Hoog-V/APPS_PCB/Smaller_prototype.step

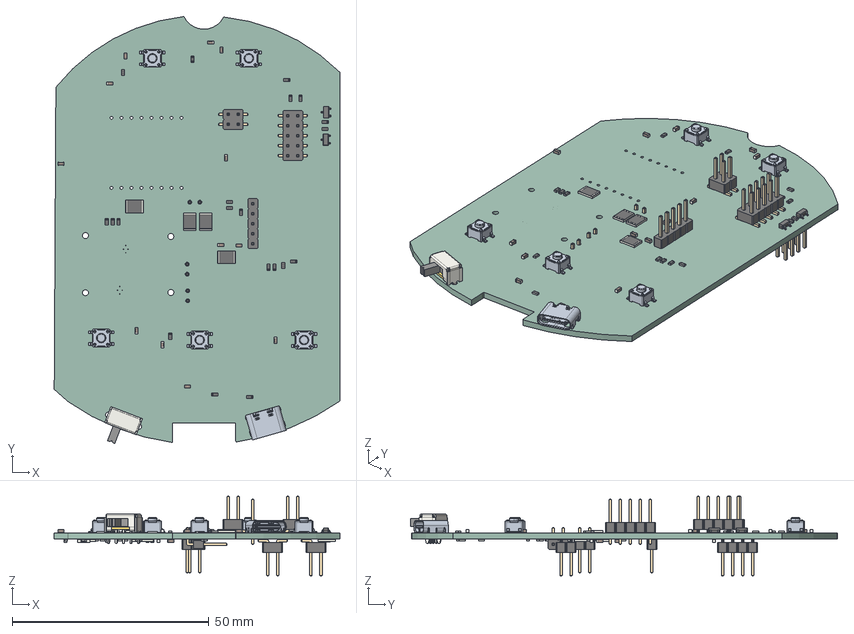
[picture p1: CAD file, 2024-05-29]
Smaller_prototype.step
72.5 x 108.4 x 20.3 mm
C_0603_1608Metric x 23
R_0603_1608Metric x 39
PinHeader_1x05_P254mm_Vertical
CU97M05647FP x 5
R_1812_4532Metric x 8
SW_Slide_SPDT_Angled_CK_OS102011MA1Q
GSB1C41X111DS1HR
PinHeader_2x02_P254mm_Vertical_SMD x 2
PinHeader_2x05_P254mm_Vertical_SMD
SOT_23 x 2
PinHeader_1x02_P254mm_Horizontal
PinHeader_1x02_P254mm_Vertical x 2
PinHeader_2x04_P254mm_Vertical_SMD
Smaller_prototype_PCB
