Hoog-V/APPS_PCB/Smaller_prototype.kicad_pcb

## KiCad design Smaller_prototype.kicad_pcb (2024-05-30)

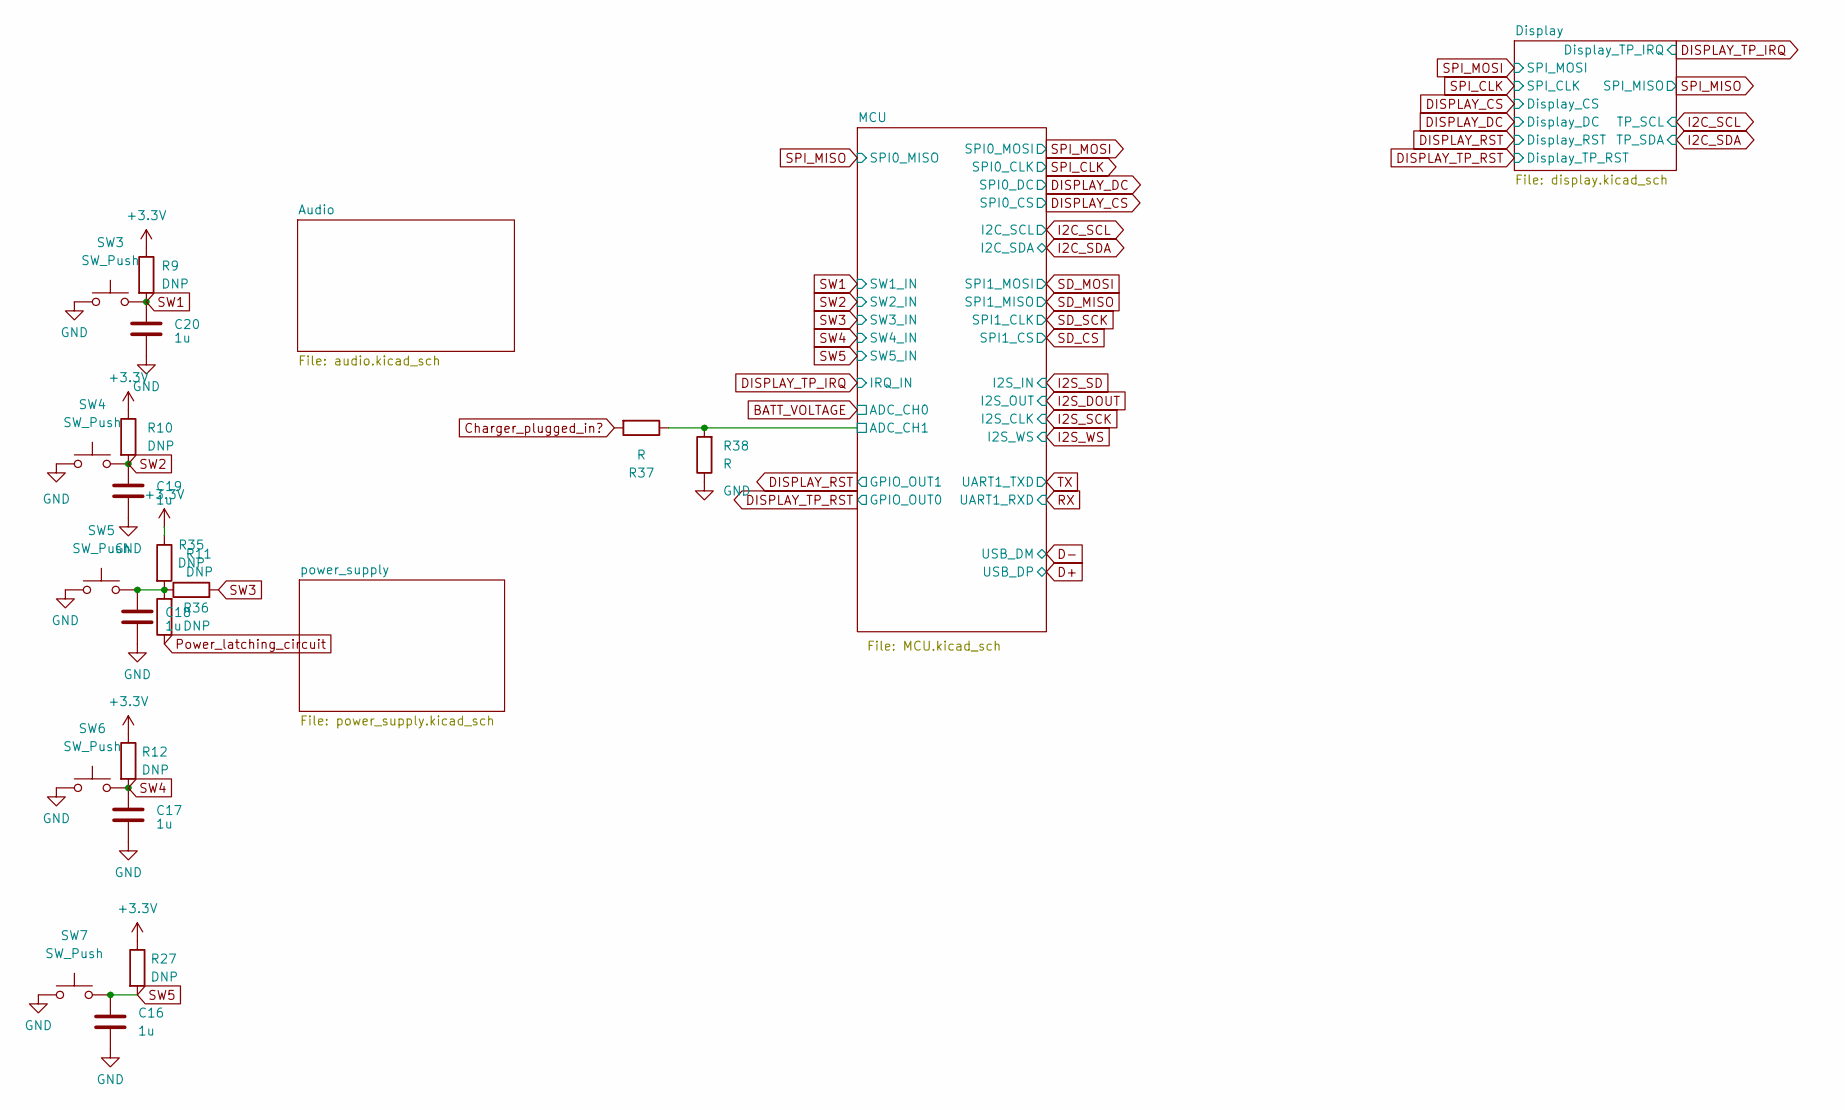
[picture p2: schematic Smaller_prototype.kicad_sch]

Parts:
C16, C17, C18, C19, C20: 1u; C_0603_1608Metric_Pad1.08x0.95mm_HandSolder
R9, R10, R11, R12, R27, R35, R36: DNP; R_0603_1608Metric_Pad0.98x0.95mm_HandSolder
R37, R38: R; R_0603_1608Metric_Pad0.98x0.95mm_HandSolder
SW3, SW4, SW5, SW6, SW7: SW_Push; SW_SPST_B3S-1000

Connections:
+3.3V: R9.1, R10.1, R11.1, R12.1, R27.1; also elsewhere on the board
/MCU/ADC_CH1: R37.1, R38.2; also elsewhere on the board
Charger_plugged_in?: R37.2; also elsewhere on the board
GND: C16.2, C17.2, C18.2, C19.2, C20.2, R38.1, SW3.1, SW4.1, SW5.1, SW6.1, SW7.1; also elsewhere on the board
unnamed: C18.1, R11.2, R35.1, R36.2, SW5.2
Power_latching_circuit: R36.1; also elsewhere on the board
SW1: C20.1, R9.2, SW3.2; also elsewhere on the board
SW2: C19.1, R10.2, SW4.2; also elsewhere on the board
SW3: R35.2; also elsewhere on the board
SW4: C17.1, R12.2, SW6.2; also elsewhere on the board
SW5: C16.1, R27.2, SW7.2; also elsewhere on the board

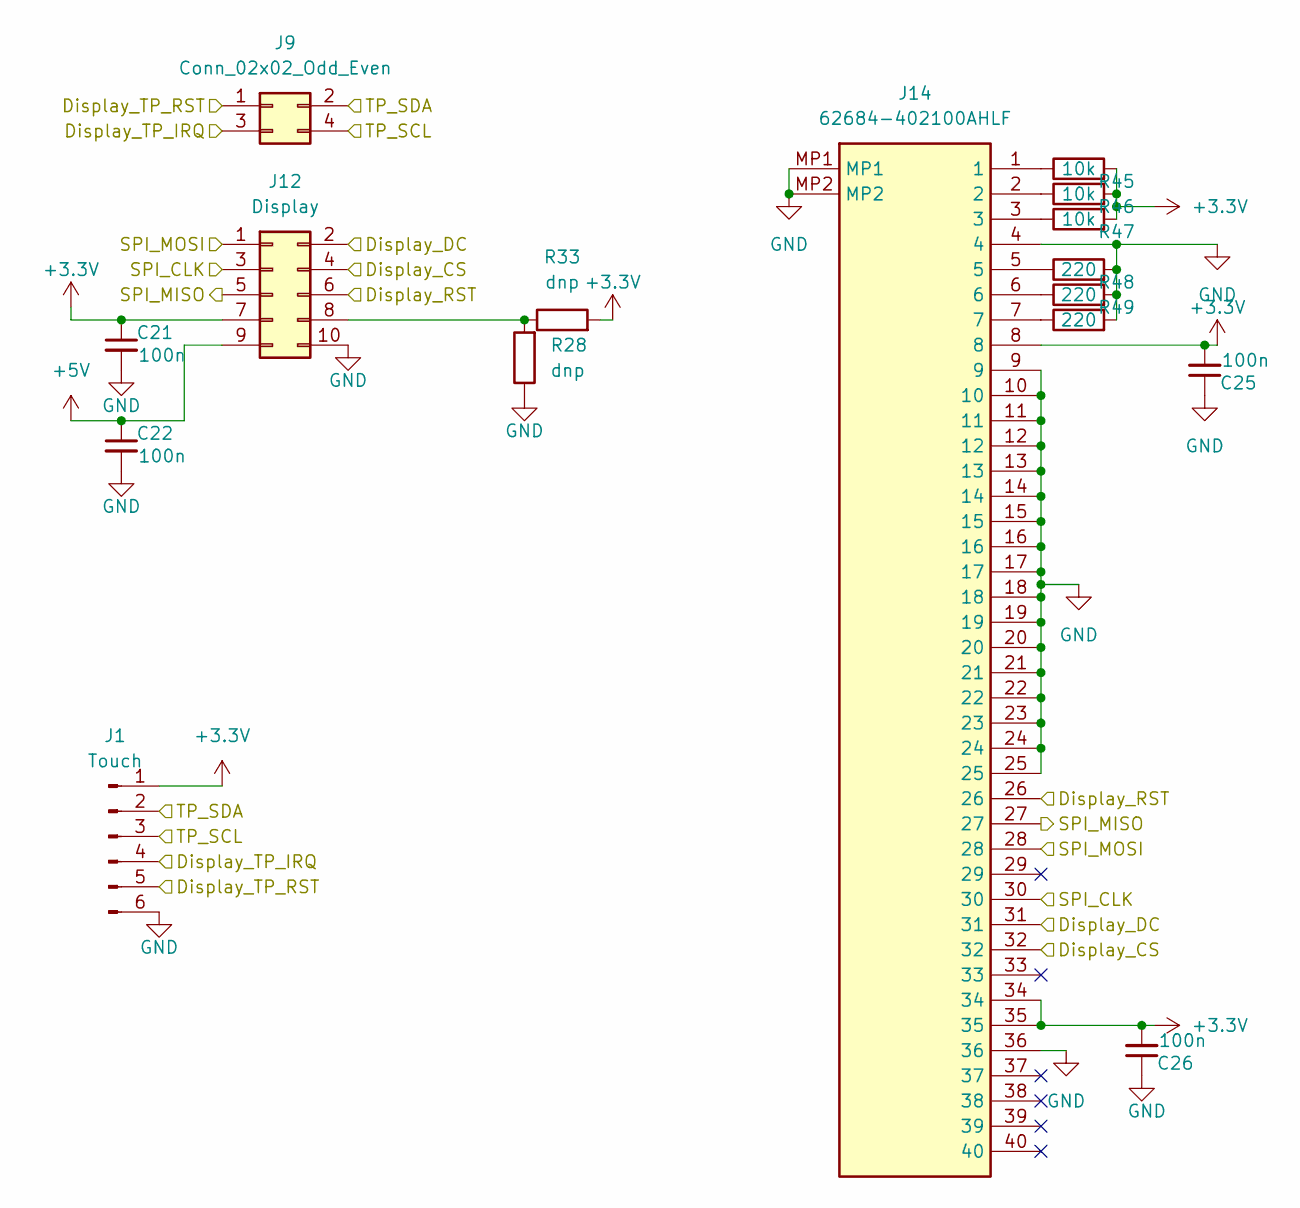
[picture p3: schematic display.kicad_sch]

Parts:
C21, C22, C25, C26: 100n; C_0603_1608Metric_Pad1.08x0.95mm_HandSolder
J1: Touch; TE_0-1734839-6_1x06-1MP_P0.5mm_Horizontal
J9: Conn_02x02_Odd_Even; PinHeader_2x02_P2.54mm_Vertical_SMD
J12: Display; PinHeader_2x05_P2.54mm_Vertical_SMD
J14: 62684-402100AHLF; 62684402100AHLF; Manufacturer_Part_Number 62684-402100AHLF
R28, R33: dnp; R_0603_1608Metric_Pad0.98x0.95mm_HandSolder
R45, R46, R47: 10k; R_0603_1608Metric_Pad0.98x0.95mm_HandSolder
R48, R49, R50: 220; R_0603_1608Metric_Pad0.98x0.95mm_HandSolder

Connections:
+3.3V: C21.1, C25.2, C26.2, J1.1, J12.7, J14.8, J14.34, J14.35, R33.2, R45.2, R46.2, R47.2; also elsewhere on the board
+5V: C22.1, J12.9; also elsewhere on the board
DISPLAY_CS: J12.4, J14.32; also elsewhere on the board
DISPLAY_DC: J12.2, J14.31; also elsewhere on the board
DISPLAY_RST: J12.6, J14.26; also elsewhere on the board
DISPLAY_TP_IRQ: J1.4, J9.3; also elsewhere on the board
DISPLAY_TP_RST: J1.5, J9.1; also elsewhere on the board
GND: C21.2, C22.2, C25.1, C26.1, J1.6, J12.10, J14.4, J14.9, J14.10, J14.11, J14.12, J14.13, J14.14, J14.15, J14.16, J14.17, J14.18, J14.19, J14.20, J14.21, J14.22, J14.23, J14.24, J14.25, J14.36, J14.MP1, J14.MP2, R28.1, R48.2, R49.2, R50.2; also elsewhere on the board
I2C_SCL: J1.3, J9.4; also elsewhere on the board
I2C_SDA: J1.2, J9.2; also elsewhere on the board
unnamed: J12.8, R28.2, R33.1
unnamed: J14.1, R45.1
unnamed: J14.2, R46.1
unnamed: J14.3, R47.1
unnamed: J14.5, R48.1
unnamed: J14.6, R49.1
unnamed: J14.7, R50.1
SPI_CLK: J12.3, J14.30; also elsewhere on the board
SPI_MISO: J12.5, J14.27; also elsewhere on the board
SPI_MOSI: J12.1, J14.28; also elsewhere on the board

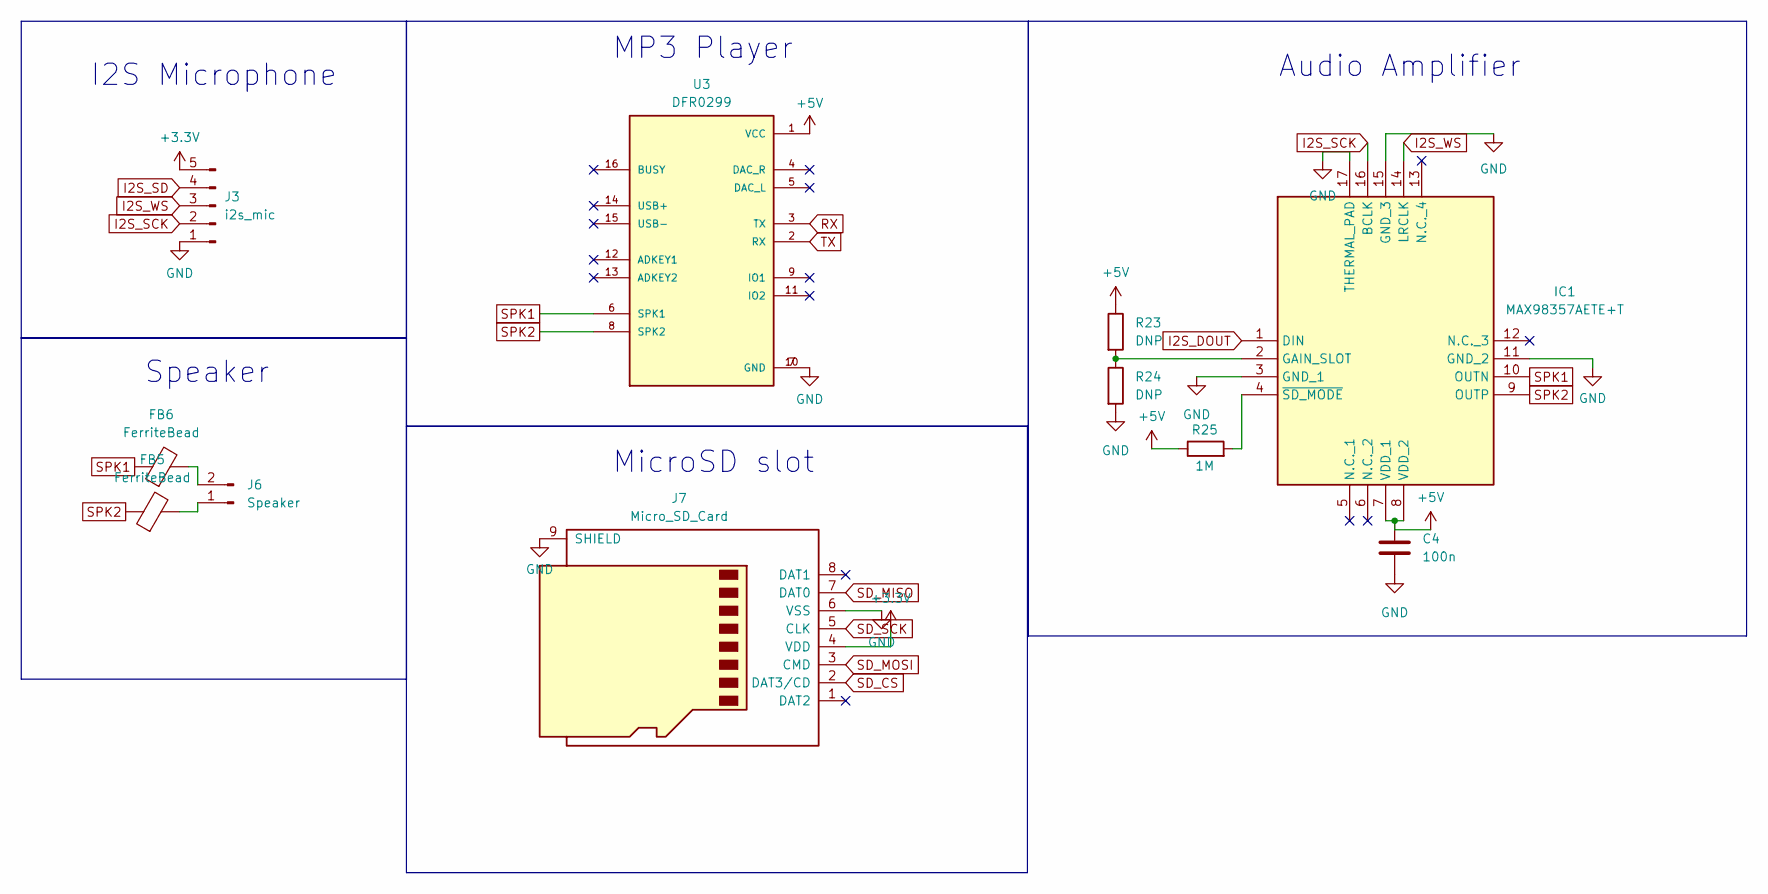
[picture p4: schematic audio.kicad_sch]

Parts:
C4: 100n; C_0603_1608Metric_Pad1.08x0.95mm_HandSolder
FB5, FB6: FerriteBead; R_1812_4532Metric
IC1: MAX98357AETE+T; QFN50P300X300X80-17N; Mouser Part Number 700-MAX98357AETE+T
J3: i2s_mic; PinHeader_1x05_P2.54mm_Vertical
J6: Speaker; PinHeader_1x02_P2.54mm_Vertical
J7: Micro_SD_Card; microSD_HC_Molex_47219-2001
R23, R24: DNP; R_0603_1608Metric_Pad0.98x0.95mm_HandSolder
R25: 1M; R_0603_1608Metric_Pad0.98x0.95mm_HandSolder
U3: DFR0299; DFPlayer_V2

Connections:
+3.3V: J3.5, J7.4 (VDD); also elsewhere on the board
+5V: C4.1, IC1.7 (VDD_1), IC1.8 (VDD_2), R23.1, R25.1, U3.1 (VCC); also elsewhere on the board
GND: C4.2, IC1.3 (GND_1), IC1.11 (GND_2), IC1.15 (GND_3), IC1.17 (THERMAL_PAD), J3.1, J7.6 (VSS), J7.9 (SHIELD), R24.2, U3.7 (GND), U3.10 (GND); also elsewhere on the board
I2S_DOUT: IC1.1 (DIN); also elsewhere on the board
I2S_SCK: IC1.16 (BCLK), J3.2; also elsewhere on the board
I2S_SD: J3.4; also elsewhere on the board
I2S_WS: IC1.14 (LRCLK), J3.3; also elsewhere on the board
unnamed: IC1.2 (GAIN_SLOT), R23.2, R24.1
unnamed: IC1.4 (~SD_MODE), R25.2
unnamed: FB5.2, J6.1
unnamed: FB6.2, J6.2
RX: U3.3 (TX); also elsewhere on the board
SD_CS: J7.2 (DAT3/CD); also elsewhere on the board
SD_MISO: J7.7 (DAT0); also elsewhere on the board
SD_MOSI: J7.3 (CMD); also elsewhere on the board
SD_SCK: J7.5 (CLK); also elsewhere on the board
SPK1: FB6.1, IC1.10 (OUTN), U3.6 (SPK1)
SPK2: FB5.1, IC1.9 (OUTP), U3.8 (SPK2)
TX: U3.2 (RX); also elsewhere on the board

Notes on the sheet:
Speaker
MP3 Player
I2S Microphone
Audio Amplifier
MicroSD slot

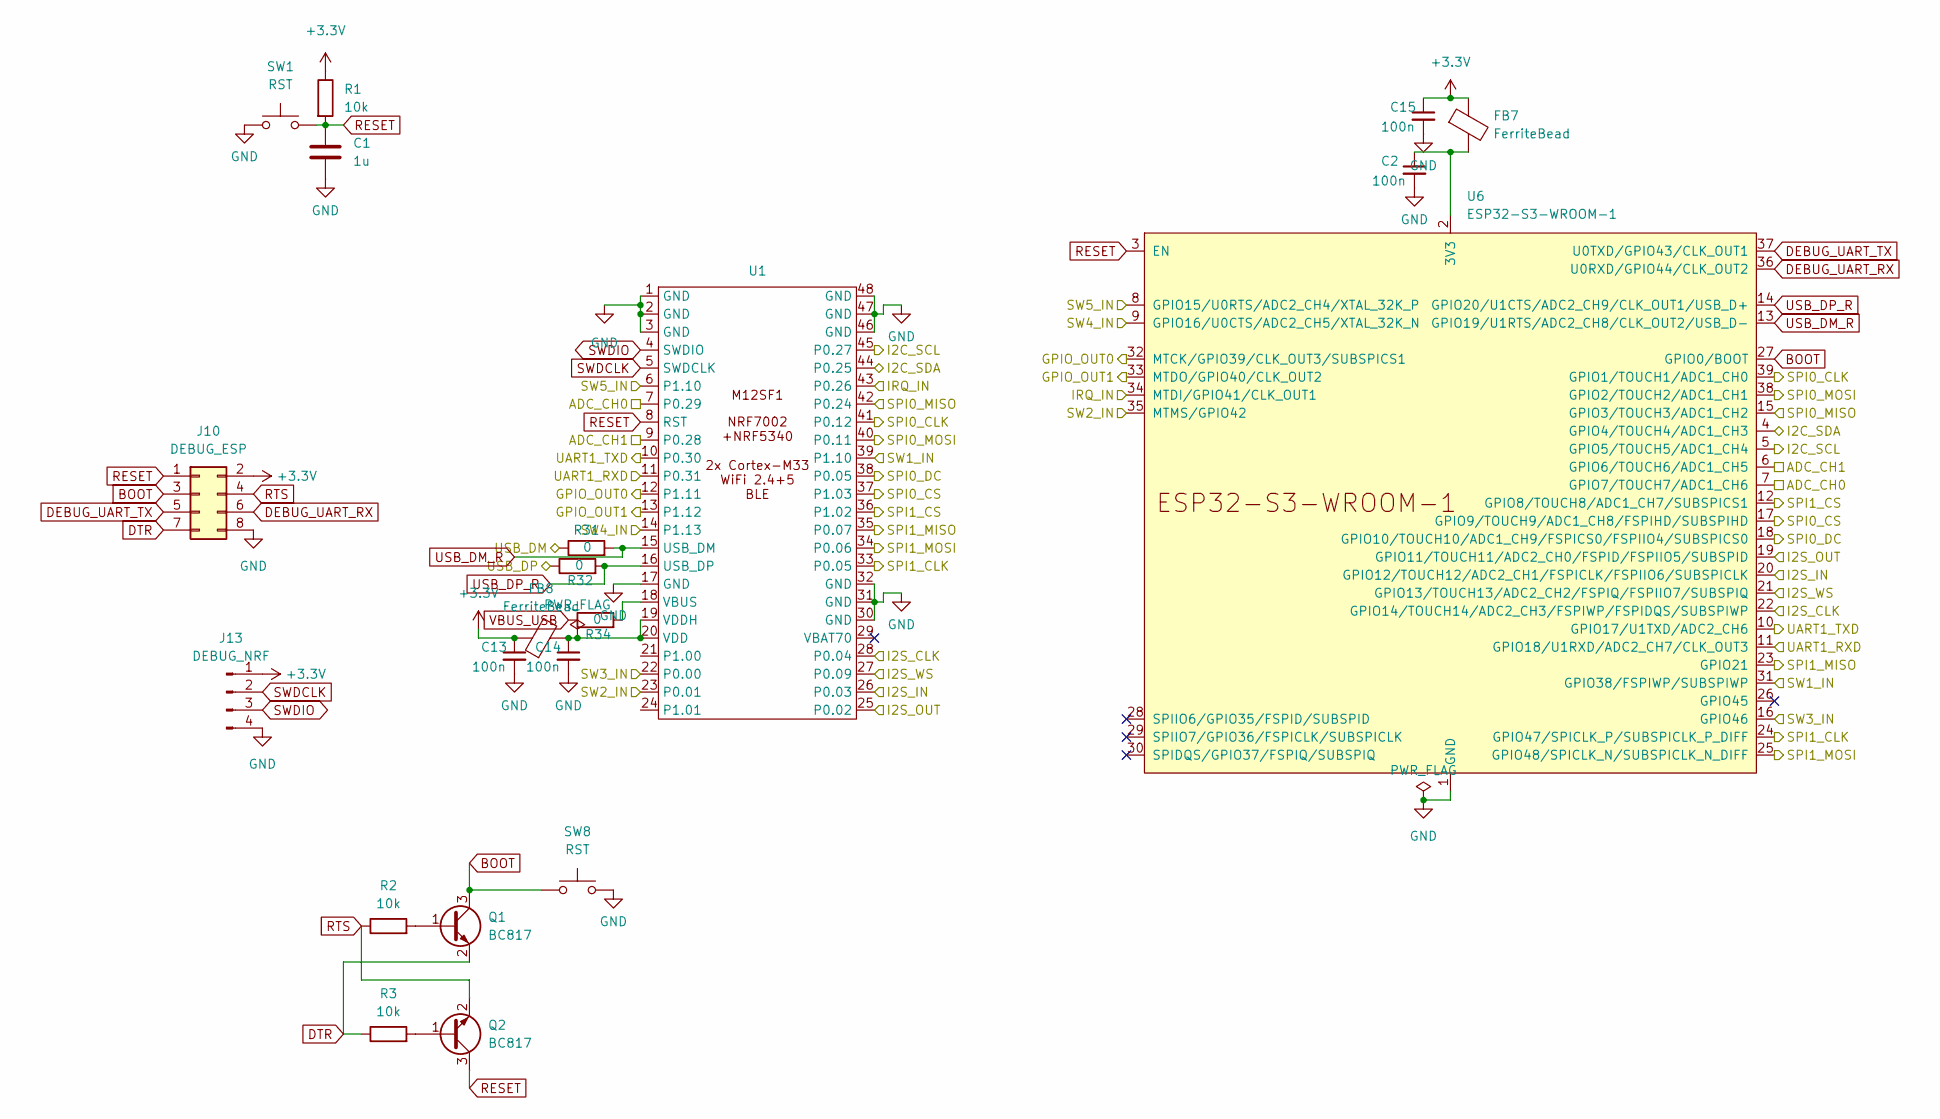
[picture p5: schematic MCU.kicad_sch]

Parts:
C1: 1u; C_0603_1608Metric_Pad1.08x0.95mm_HandSolder
C2, C13, C14, C15: 100n; C_0603_1608Metric_Pad1.08x0.95mm_HandSolder
FB7, FB8: FerriteBead; R_1812_4532Metric
J10: DEBUG_ESP; PinHeader_2x04_P2.54mm_Vertical_SMD
J13: DEBUG_NRF; PinHeader_2x02_P2.54mm_Vertical_SMD
Q1, Q2: BC817; SOT-23
R1, R2, R3: 10k; R_0603_1608Metric_Pad0.98x0.95mm_HandSolder
R31, R32, R34: 0; R_0603_1608Metric_Pad0.98x0.95mm_HandSolder
SW1, SW8: RST; SW_SPST_B3S-1000
U1: M12SF1
U6: ESP32-S3-WROOM-1

Connections:
+3.3V: C13.1, C15.1, FB7.1, FB8.1, J10.2, J13.1, R1.1; also elsewhere on the board
/MCU/ADC_CH1: U1.9 (P0.28), U6.6 (GPIO6/TOUCH6/ADC1_CH5); also elsewhere on the board
BATT_VOLTAGE: U1.7 (P0.29), U6.7 (GPIO7/TOUCH7/ADC1_CH6); also elsewhere on the board
BOOT: J10.3, Q1.3 (C), SW8.1, U6.27 (GPIO0/BOOT)
D+: R32.1; also elsewhere on the board
D-: R31.1; also elsewhere on the board
DEBUG_UART_RX: J10.6, U6.36 (U0RXD/GPIO44/CLK_OUT2)
DEBUG_UART_TX: J10.5, U6.37 (U0TXD/GPIO43/CLK_OUT1)
DISPLAY_CS: U1.37 (P1.03), U6.17 (GPIO9/TOUCH9/ADC1_CH8/FSPIHD/SUBSPIHD); also elsewhere on the board
DISPLAY_DC: U1.38 (P0.05), U6.18 (GPIO10/TOUCH10/ADC1_CH9/FSPICS0/FSPIIO4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); also elsewhere on the board
DISPLAY_RST: U1.13 (P1.12), U6.33 (MTDO/GPIO40/CLK_OUT2); also elsewhere on the board
DISPLAY_TP_IRQ: U1.43 (P0.26), U6.34 (MTDI/GPIO41/CLK_OUT1); also elsewhere on the board
DISPLAY_TP_RST: U1.12 (P1.11), U6.32 (MTCK/GPIO39/CLK_OUT3/SUBSPICS1); also elsewhere on the board
DTR: J10.7, Q1.2 (E), R3.1
GND: C1.2, C2.2, C13.2, C14.2, C15.2, J10.8, J13.4, SW1.1, SW8.2, U1.1 (GND), U1.2 (GND), U1.3 (GND), U1.17 (GND), U1.30 (GND), U1.31 (GND), U1.32 (GND), U1.46 (GND), U1.47 (GND), U1.48 (GND), U6.1 (GND), U6.40 (GND), U6.41 (GND); also elsewhere on the board
I2C_SCL: U1.45 (P0.27), U6.5 (GPIO5/TOUCH5/ADC1_CH4); also elsewhere on the board
I2C_SDA: U1.44 (P0.25), U6.4 (GPIO4/TOUCH4/ADC1_CH3); also elsewhere on the board
I2S_DOUT: U1.25 (P0.02), U6.19 (GPIO11/TOUCH11/ADC2_CH0/FSPID/FSPIIO5/S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); also elsewhere on the board
I2S_SCK: U1.28 (P0.04), U6.22 (GPIO14/TOUCH14/ADC2_CH3/FSPIWP/FSPIDQS/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); also elsewhere on the board
I2S_SD: U1.26 (P0.03), U6.20 (GPIO12/TOUCH12/ADC2_CH1/FSPICLK/FSPIIO6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); also elsewhere on the board
I2S_WS: U1.27 (P0.09), U6.21 (GPIO13/TOUCH13/ADC2_CH2/FSPIQ/FSPIIO7/S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); also elsewhere on the board
unnamed: Q1.1 (B), R2.2
unnamed: Q2.1 (B), R3.2
unnamed: R34.2, U1.18 (VBUS)
unnamed: C14.1, FB8.2, U1.19 (VDDH), U1.20 (VDD)
unnamed: C2.1, FB7.2, U6.2 (3V3)
RESET: C1.1, J10.1, Q2.3 (C), R1.2, SW1.2, U1.8 (RST), U6.3 (EN)
RTS: J10.4, Q2.2 (E), R2.1
RX: U1.11 (P0.31), U6.11 (GPIO18/U1RXD/ADC2_CH7/CLK_OUT3); also elsewhere on the board
SD_CS: U1.36 (P1.02), U6.12 (GPIO8/TOUCH8/ADC1_CH7/SUBSPICS1); also elsewhere on the board
SD_MISO: U1.35 (P0.07), U6.23 (GPIO21); also elsewhere on the board
SD_MOSI: U1.34 (P0.06), U6.25 (GPIO48/SPICLK_N/SUBSPICLK_N_DIFF); also elsewhere on the board
SD_SCK: U1.33 (P0.05), U6.24 (GPIO47/SPICLK_P/SUBSPICLK_P_DIFF); also elsewhere on the board
SPI_CLK: U1.41 (P0.12), U6.39 (GPIO1/TOUCH1/ADC1_CH0); also elsewhere on the board
SPI_MISO: U1.42 (P0.24), U6.15 (GPIO3/TOUCH3/ADC1_CH2); also elsewhere on the board
SPI_MOSI: U1.40 (P0.11), U6.38 (GPIO2/TOUCH2/ADC1_CH1); also elsewhere on the board
SW1: U1.39 (P1.10), U6.31 (GPIO38/FSPIWP/SUBSPIWP); also elsewhere on the board
SW2: U1.23 (P0.01), U6.35 (MTMS/GPIO42); also elsewhere on the board
SW3: U1.22 (P0.00), U6.16 (GPIO46); also elsewhere on the board
SW4: U1.14 (P1.13), U6.9 (GPIO16/U0CTS/ADC2_CH5/XTAL_32K_N); also elsewhere on the board
SW5: U1.6 (P1.10), U6.8 (GPIO15/U0RTS/ADC2_CH4/XTAL_32K_P); also elsewhere on the board
SWDCLK: J13.2, U1.5 (SWDCLK)
SWDIO: J13.3, U1.4 (SWDIO)
TX: U1.10 (P0.30), U6.10 (GPIO17/U1TXD/ADC2_CH6); also elsewhere on the board
USB_DM_R: R31.2, U1.15 (USB_DM), U6.13 (GPIO19/U1RTS/ADC2_CH8/CLK_OUT2/USB_D-)
USB_DP_R: R32.2, U1.16 (USB_DP), U6.14 (GPIO20/U1CTS/ADC2_CH9/CLK_OUT1/USB_D+)
VBUS_USB: R34.1; also elsewhere on the board

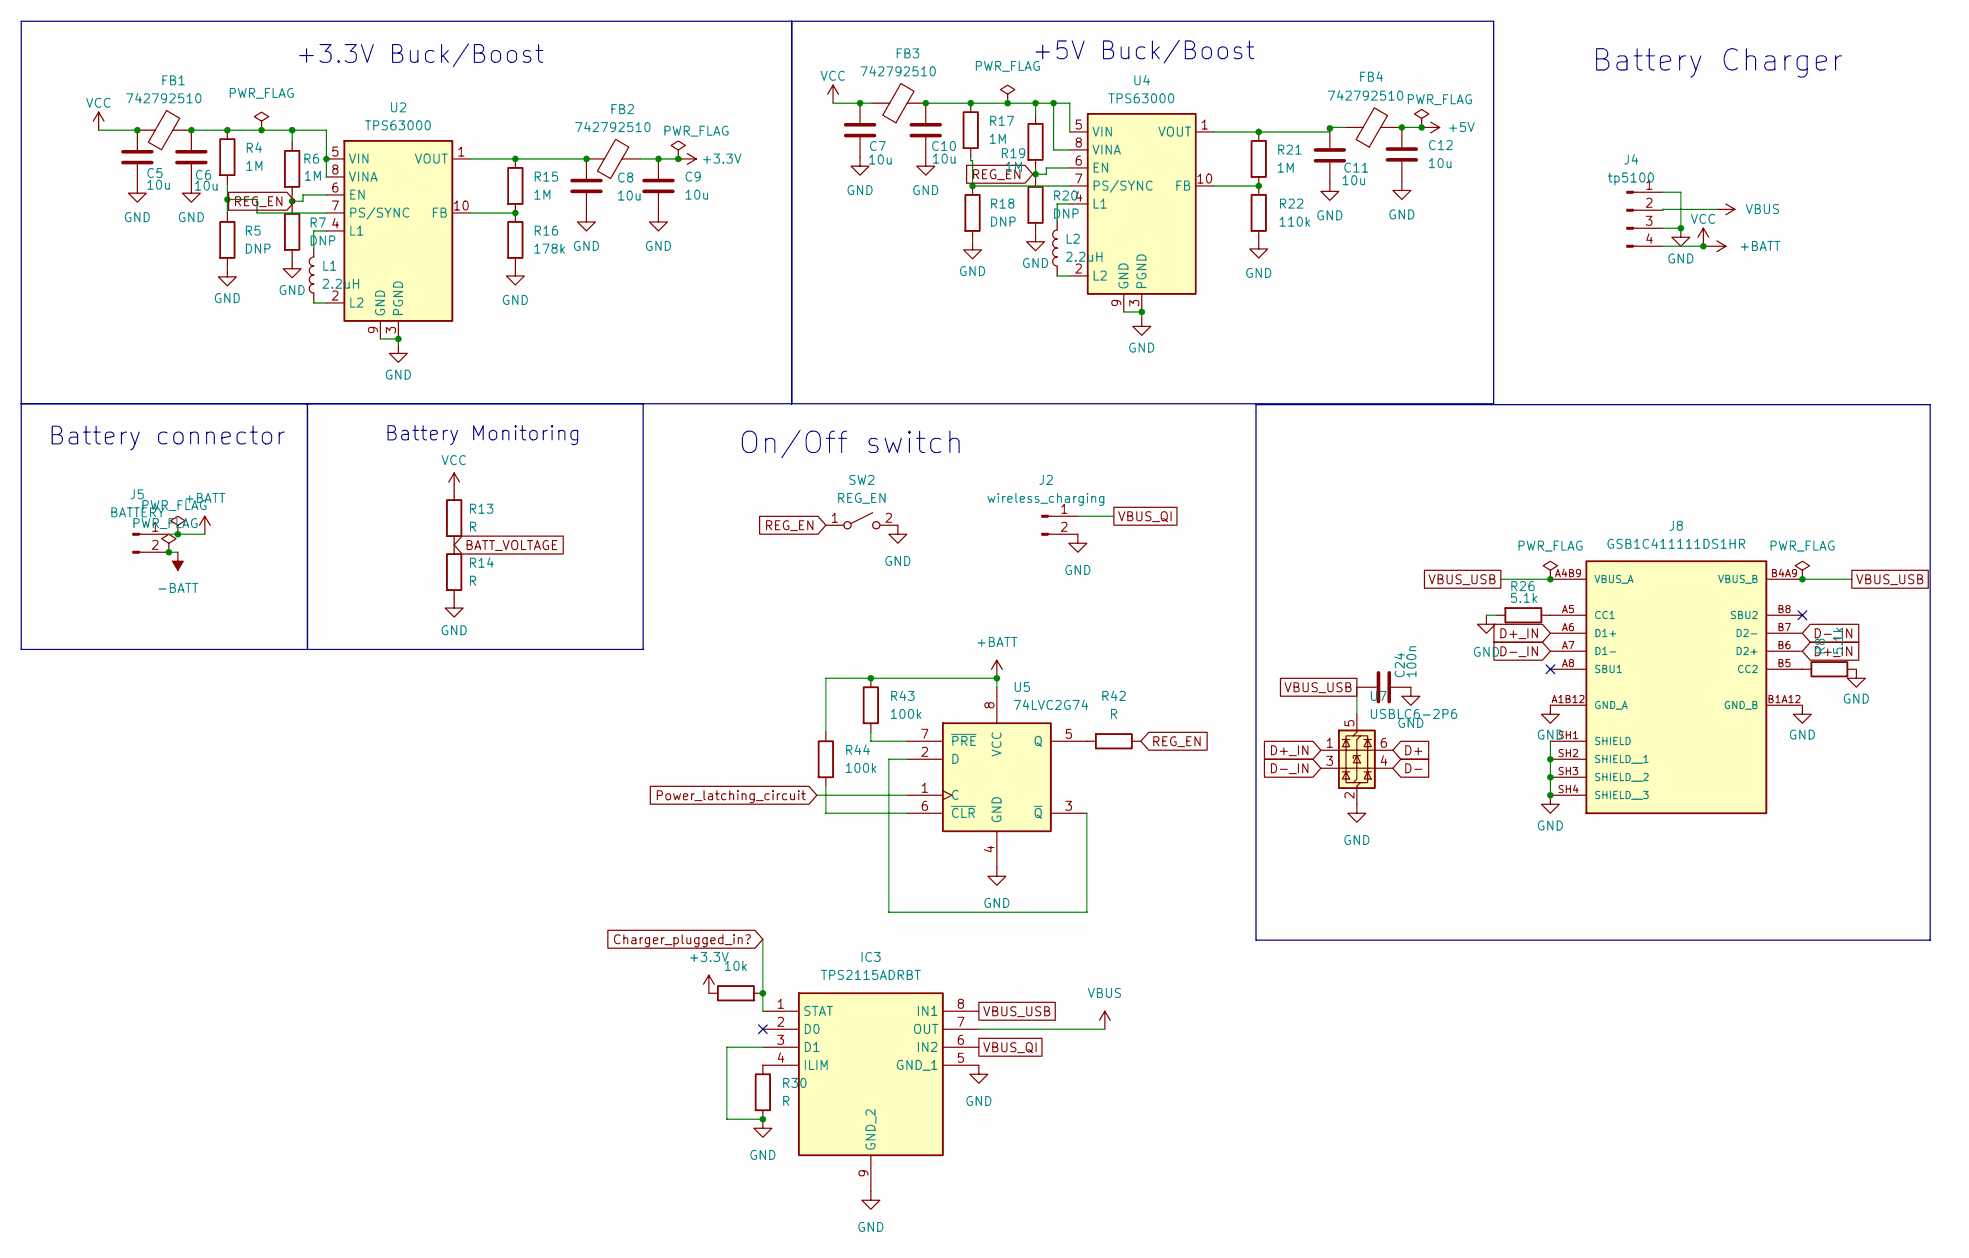
[picture p6: schematic power_supply.kicad_sch]

Parts:
C5, C6, C7, C8, C9, C10, C11, C12: 10u; C_0603_1608Metric_Pad1.08x0.95mm_HandSolder
C24: 100n; C_0603_1608Metric_Pad1.08x0.95mm_HandSolder
FB1, FB2, FB3, FB4: 742792510; R_1812_4532Metric
IC3: TPS2115ADRBT; SON65P300X300X100-9N-D; Mouser Part Number 595-TPS2115ADRBT
J2: wireless_charging; PinHeader_1x02_P2.54mm_Horizontal
J4: tp5100
J5: BATTERY; PinHeader_1x02_P2.54mm_Vertical
J8: GSB1C411111DS1HR; AMPHENOL_GSB1C411111DS1HR; PARTREV AX3
L1, L2: 2.2uH; INDC3225X120N
R4, R6, R15, R17, R19, R21: 1M; R_0603_1608Metric_Pad0.98x0.95mm_HandSolder
R5, R7, R18, R20: DNP; R_0603_1608Metric_Pad0.98x0.95mm_HandSolder
R8, R26: 5.1k; R_0603_1608Metric_Pad0.98x0.95mm_HandSolder
R13, R14, R30, R42: R; R_0603_1608Metric_Pad0.98x0.95mm_HandSolder
R16: 178k; R_0603_1608Metric_Pad0.98x0.95mm_HandSolder
R22: 110k; R_0603_1608Metric_Pad0.98x0.95mm_HandSolder
R29: 10k; R_0603_1608Metric_Pad0.98x0.95mm_HandSolder
R43, R44: 100k; R_0603_1608Metric_Pad0.98x0.95mm_HandSolder
SW2: REG_EN; SW_Slide_SPDT_Angled_CK_OS102011MA1Q
U2, U4: TPS63000; Texas_DRC0010J_ThermalVias
U5: 74LVC2G74; TSSOP-8_3x3mm_P0.65mm
U7: USBLC6-2P6; SOT-666

Connections:
+3.3V: C9.1, FB2.2, R29.1; also elsewhere on the board
+5V: C12.1, FB4.2; also elsewhere on the board
+BATT: C5.1, C7.1, FB1.1, FB3.1, J4.4, J5.1, R13.1, R43.1, R44.1, U5.8 (VCC)
-BATT: J5.2
BATT_VOLTAGE: R13.2, R14.1; also elsewhere on the board
Charger_plugged_in?: IC3.1 (STAT), R29.2; also elsewhere on the board
D+: U7.6 (I/O1); also elsewhere on the board
D+_IN: J8.A6 (D1+), J8.B6 (D2+), U7.1 (I/O1)
D-: U7.4 (I/O2); also elsewhere on the board
D-_IN: J8.A7 (D1-), J8.B7 (D2-), U7.3 (I/O2)
GND: C5.2, C6.2, C7.2, C8.2, C9.2, C10.2, C11.2, C12.2, C24.2, IC3.3 (D1), IC3.5 (GND_1), IC3.9 (GND_2), J2.2, J4.1, J4.3, J8.A1B12 (GND_A), J8.B1A12 (GND_B), J8.SH1 (SHIELD), J8.SH2 (SHIELD__1), J8.SH3 (SHIELD__2), J8.SH4 (SHIELD__3), R5.2, R7.2, R8.2, R14.2, R16.2, R18.2, R20.2, R22.2, R26.2, R30.2, SW2.2 (B), U2.3 (PGND), U2.9 (GND), U2.11 (PGND), U4.3 (PGND), U4.9 (GND), U4.11 (PGND), U5.4 (GND), U7.2 (GND); also elsewhere on the board
unnamed: IC3.4 (ILIM), R30.1
unnamed: J8.A5 (CC1), R26.1
unnamed: J8.B5 (CC2), R8.1
unnamed: R15.2, R16.1, U2.10 (FB)
unnamed: L1.2, U2.4 (L1)
unnamed: L1.1, U2.2 (L2)
unnamed: R4.2, R5.1, U2.7 (PS/SYNC)
unnamed: C6.1, FB1.2, R4.1, R6.1, U2.5 (VIN), U2.8 (VINA)
unnamed: C8.1, FB2.1, R15.1, U2.1 (VOUT)
unnamed: R21.2, R22.1, U4.10 (FB)
unnamed: L2.2, U4.4 (L1)
unnamed: L2.1, U4.2 (L2)
unnamed: R17.2, R18.1, U4.7 (PS/SYNC)
unnamed: C10.1, FB3.2, R17.1, R19.1, U4.5 (VIN), U4.8 (VINA)
unnamed: C11.1, FB4.1, R21.1, U4.1 (VOUT)
unnamed: U5.2 (D), U5.3 (~Q)
unnamed: R42.2, U5.5 (Q)
unnamed: R44.2, U5.6 (~CLR)
unnamed: R43.2, U5.7 (~PRE)
Power_latching_circuit: U5.1 (C); also elsewhere on the board
REG_EN: R6.2, R7.1, R19.2, R20.1, R42.1, SW2.1 (A), U2.6 (EN), U4.6 (EN)
VBUS: IC3.7 (OUT), J4.2
VBUS_QI: IC3.6 (IN2), J2.1
VBUS_USB: C24.1, IC3.8 (IN1), J8.A4B9 (VBUS_A), J8.B4A9 (VBUS_B), U7.5 (VBUS); also elsewhere on the board

Notes on the sheet:
+3.3V Buck/Boost
Battery Charger
Battery Monitoring
On/Off switch
+5V Buck/Boost
Battery connector

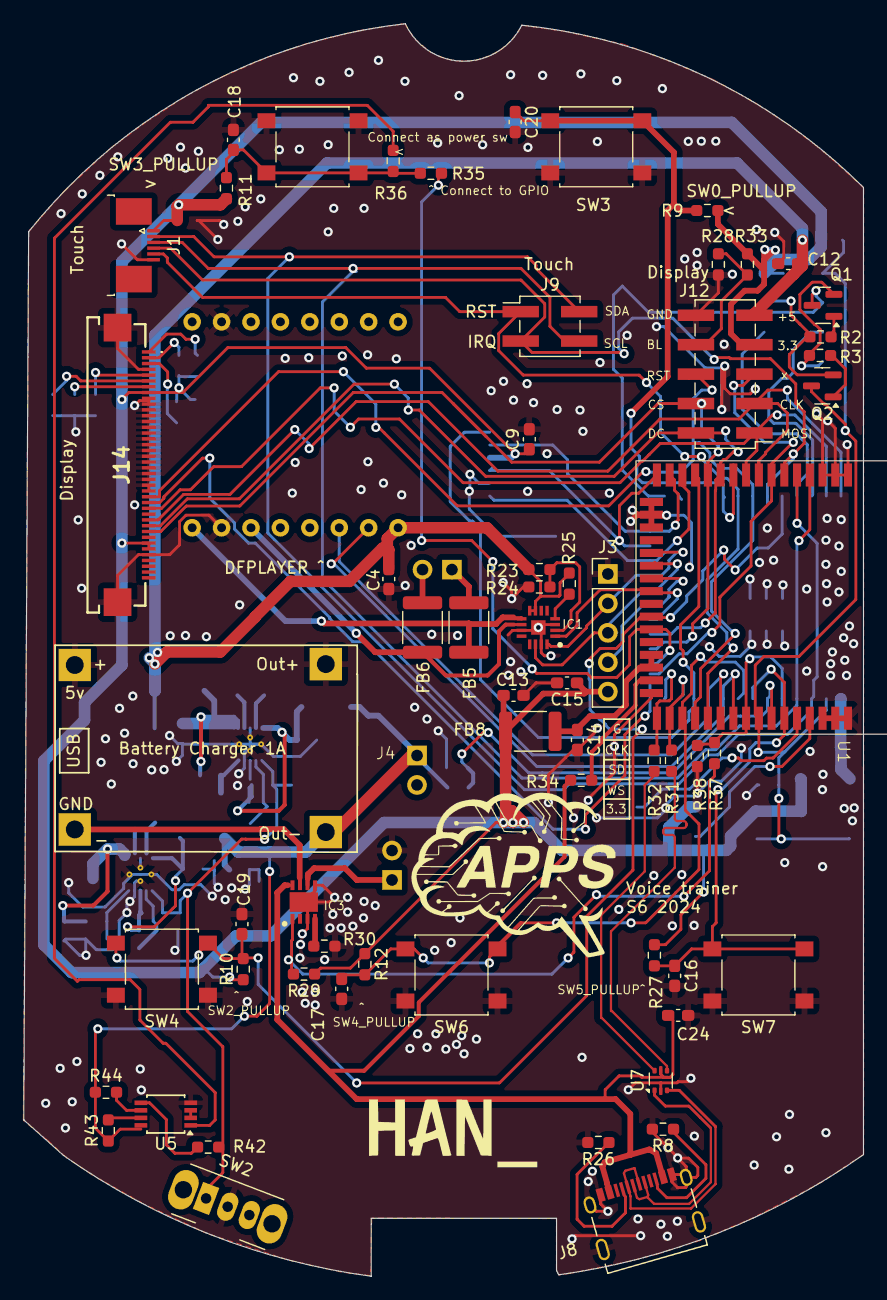
[picture p7: board Smaller_prototype.kicad_pcb from above]

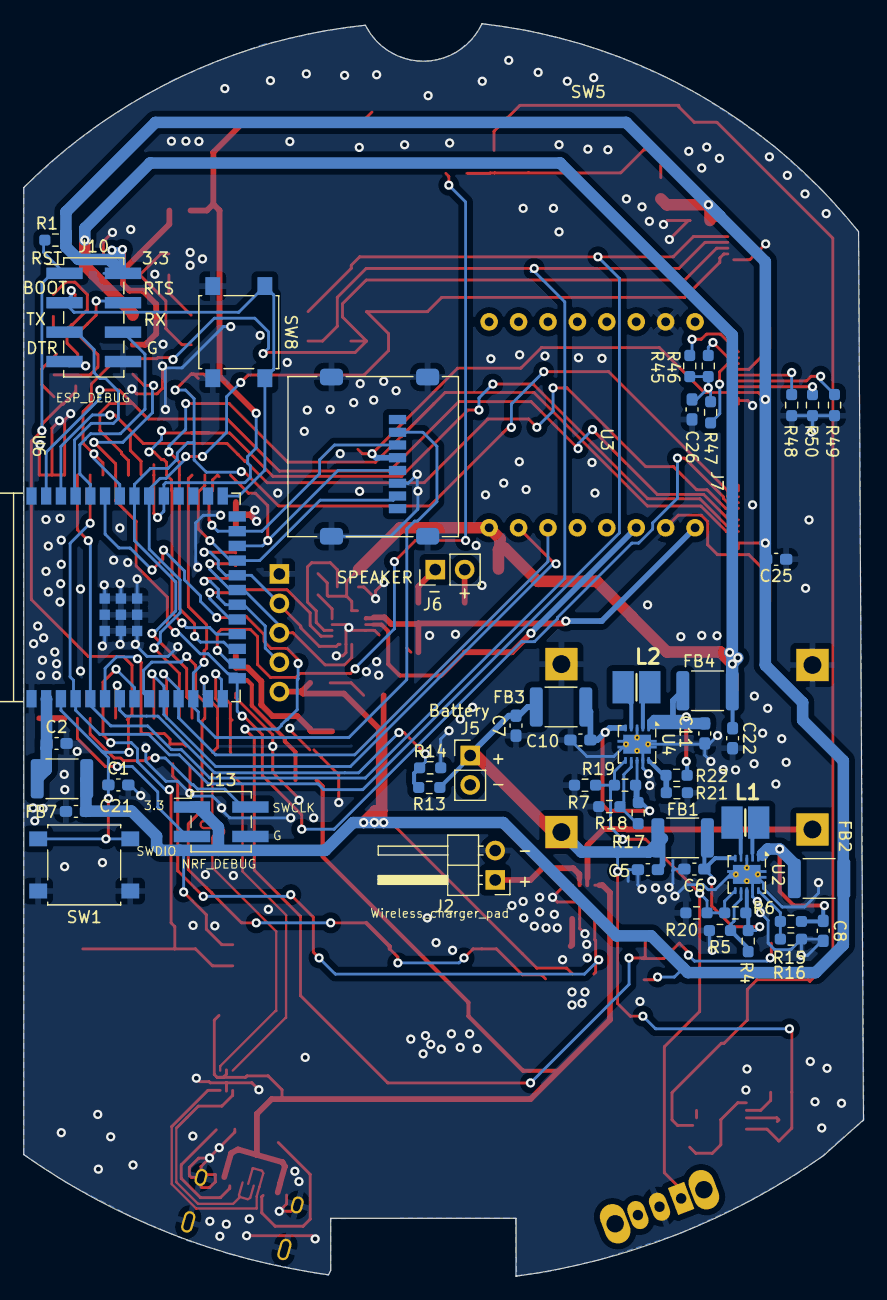
[picture p8: board Smaller_prototype.kicad_pcb from below]

Board: 2 copper layers, 72.5 x 108.1 mm, 113 parts (52 on the bottom side), 89 nets.
