Hoog-V/APPS_PCB/(commit log)

2024-05-19 -add first revision of schematic
    [MCU.kicad_sch, Smaller_prototype.kicad_pcb, Smaller_prototype.kicad_sch, audio.kicad_sch, display.kicad_sch, power_supply.kicad_sch]
2024-05-27 -add some changes to power section and display
    [MCU.kicad_sch, Smaller_prototype.kicad_pcb, Smaller_prototype.kicad_sch, audio.kicad_sch, display.kicad_sch, power_supply.kicad_sch]
2024-05-27 -enh repin mcu in schematic
    [MCU.kicad_sch, Smaller_prototype.kicad_pcb, Smaller_prototype.kicad_sch, display.kicad_sch]
2024-05-29 -add soft latching circuit, routing mostly done
    [MCU.kicad_sch, Smaller_prototype.kicad_pcb, Smaller_prototype.kicad_sch, Smaller_prototype.step, power_supply.kicad_sch]
2024-05-30 -add end revision
    [MCU.kicad_sch, Smaller_prototype.kicad_pcb, Smaller_prototype.kicad_sch, audio.kicad_sch, display.kicad_sch, power_supply.kicad_sch]
